psg-titech/FRMIDIConBoard1/README.md

# FRMIDIConBoard1
Functional Reactive MIDI Controller Board #1

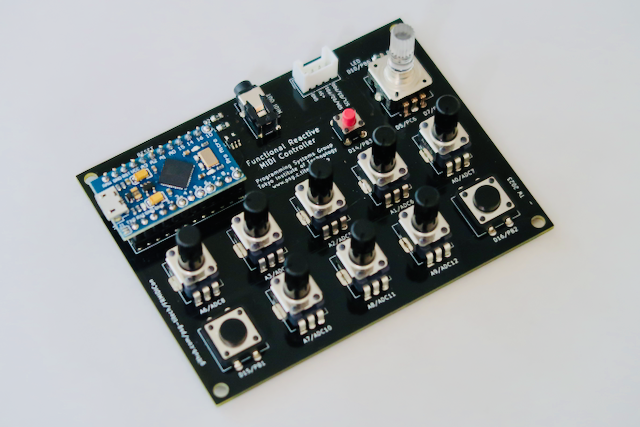
[picture p1: images/board.png]
Board Image
