psg-titech/FRMIDIConBoard1/docs/bom.xlsx

ID | Description | Model | Manufacturer | PCS | Manufacturer URL | Shop URL1 | Shop URL2
U1 | Single Buffer Gate | 74AHC1G125W5 | Diodes Incorporated | 1 |  | https://akizukidenshi.com/catalog/g/gI-17605/
C1 | Ceramic Capasitor 0.1u SMD 2012 | TMK212F104ZQ-T | Taiyo Yuden | 1 |  | https://akizukidenshi.com/catalog/g/gP-17818/
R1, R2 | Resistor 220ohm SMD 2012 | RK73B2ATTD221J | KOA | 2 | https://www.koaglobal.com/~/media/Files/KOA_Global/EN/product/commonpdf/rk73b | https://www.sengoku.co.jp/mod/sgk_cart/detail.php?code=EEHD-57BH
R3 | Resistor 470ohm SMD 2012 | RK73B2ATTD471J | KOA | 1 | https://www.koaglobal.com/~/media/Files/KOA_Global/EN/product/commonpdf/rk73b | https://www.sengoku.co.jp/mod/sgk_cart/detail.php?code=EEHD-57BS
SW1, SW2 | Tactical Switch 12mm TH | TVGP01-G73BB | Zhejiang Jianfu Electronics | 2 |  | https://akizukidenshi.com/catalog/g/gP-09826/ | https://www.amazon.co.jp/gp/product/B07J66NDTR
SW3 | Rotary Encoder with LED | EC12PLRVF-D-24K-24-24C-02/06-6 | Top-Up Industry Corporation | 1 |  | https://akizukidenshi.com/catalog/g/gP-05762/
SW4 | Tactical Switch 6mm TH | DTS-63-F-N-V-RED | Cosland Co,. Ltd. | 1 |  | https://akizukidenshi.com/catalog/g/gP-03646/
SW5 | Tactical Switch 6mm SMD | TVAF06-A020B-R | Zhejiang Jianfu Electronics | 1 |  | https://akizukidenshi.com/catalog/g/gP-14888/
RV1-8 | Rotary Potentiometer 10KB | RK09K1130A5R | Alps Alpine | 8 | https://tech.alpsalpine.com/j/products/detail/RK09K1130A5R/ | https://www.zaikostore.com/zaikostore/stockDetail?productName_forFind=RK09K1130A5R | https://www.amazon.co.jp/gp/product/B07TFTK41V
J1 | IC Socket 24P 600mil | 2227MC-24-06 | Neltron Industrial | 1 |  | https://akizukidenshi.com/catalog/g/gP-00032/
J2 | Grove Female Header 4pin/2mm TH | SKU110990030 | Seeed Studio | 1 | https://www.seeedstudio.com/Grove-Universal-4-pin-connector.html | https://www.switch-science.com/products/1122 | https://www.sengoku.co.jp/mod/sgk_cart/detail.php?code=EEHD-4KKK | https://www.marutsu.co.jp/pc/i/829425/
J3 | 3.5mm Phone Jack | ST-005-G | Switronic lndustrial Corp. | 1 |  | https://akizukidenshi.com/catalog/g/gC-02460/
 | Microcontroller Board | Pro Micro 5V/16MHz | Sparkfun | 1 | https://www.sparkfun.com/products/12640 | https://www.switch-science.com/products/1623
 | IC Connector 2.54mm 1x40 | 6604P-40G-121 | Neltron Industrial | 1 |  | https://akizukidenshi.com/catalog/g/gP-01382/
