psg-titech/FRMIDIConBoard1/docs/schematic.pdf

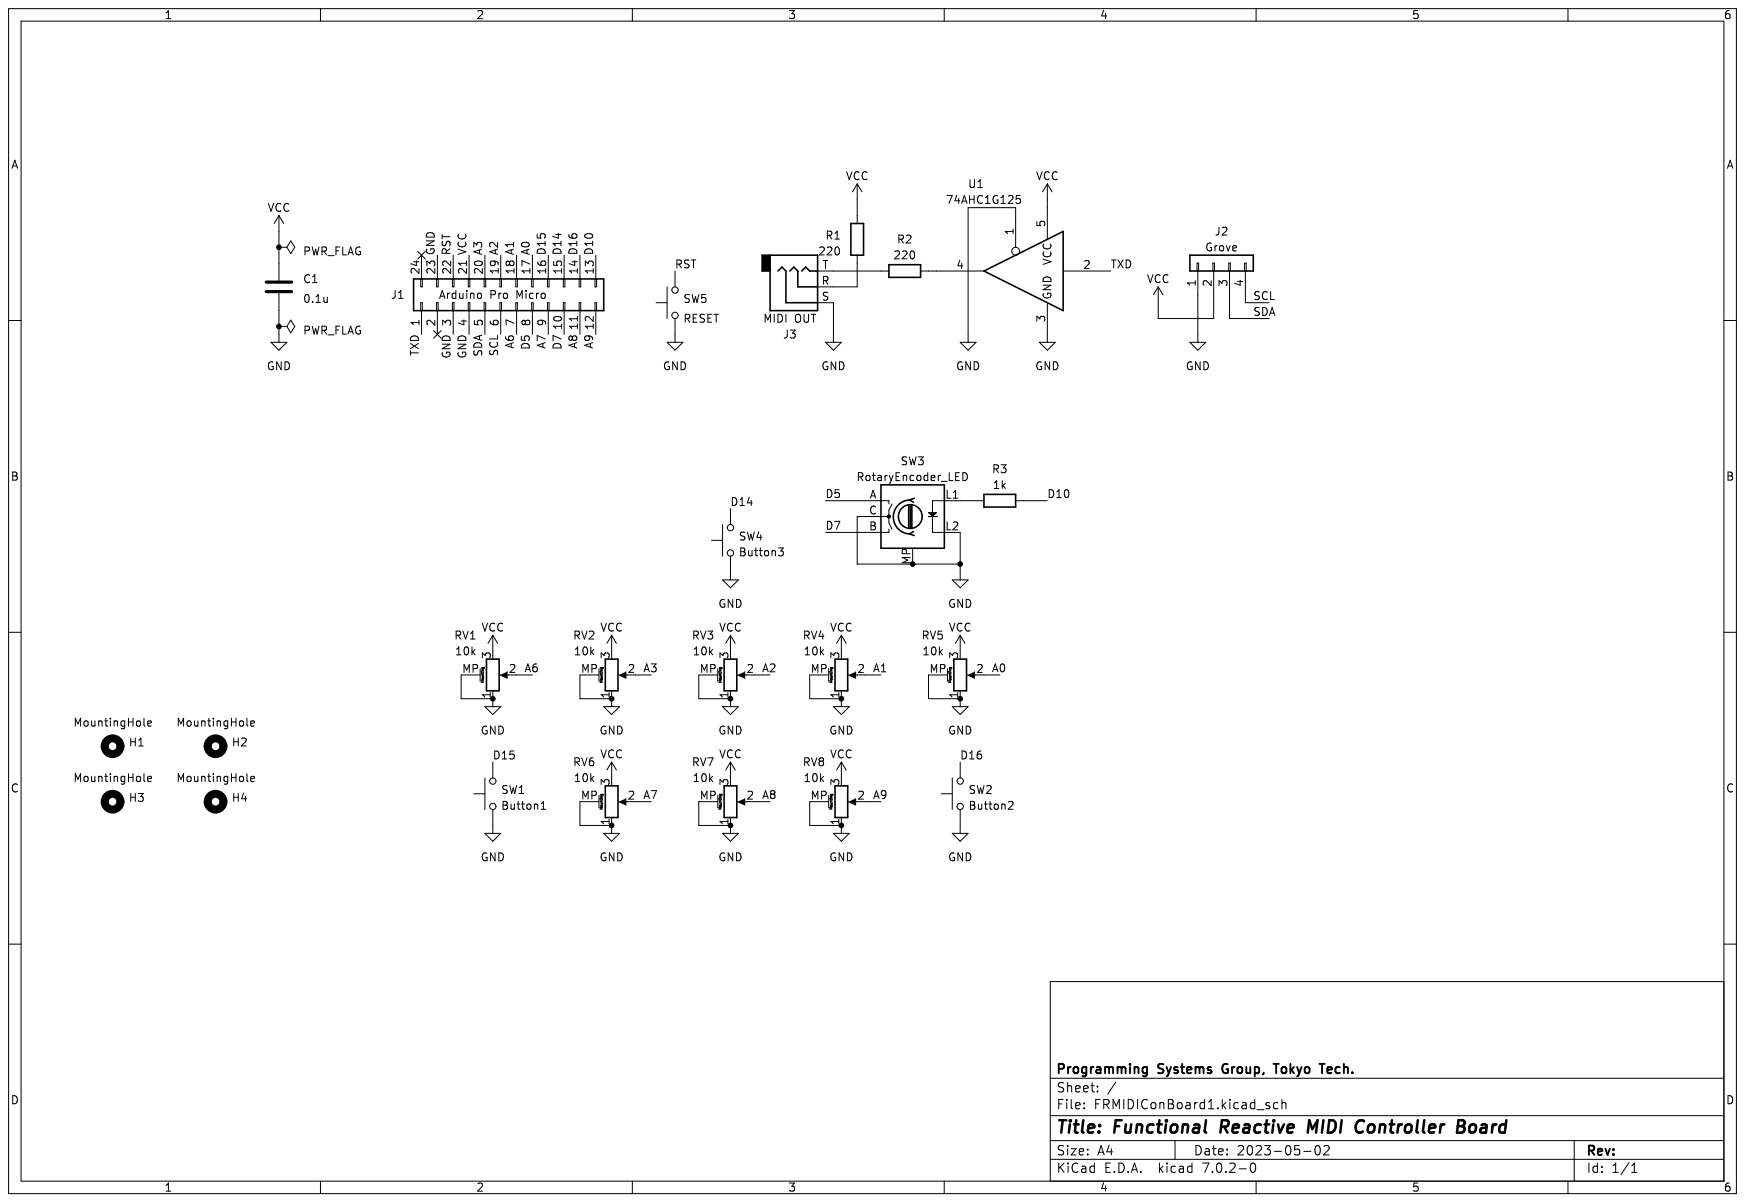
[picture p2: page 1]
