psg-titech/FRMIDIConBoard1/FRMIDIConBoard1.kicad_pcb

## KiCad design FRMIDIConBoard1.kicad_pcb (2023-05-13)

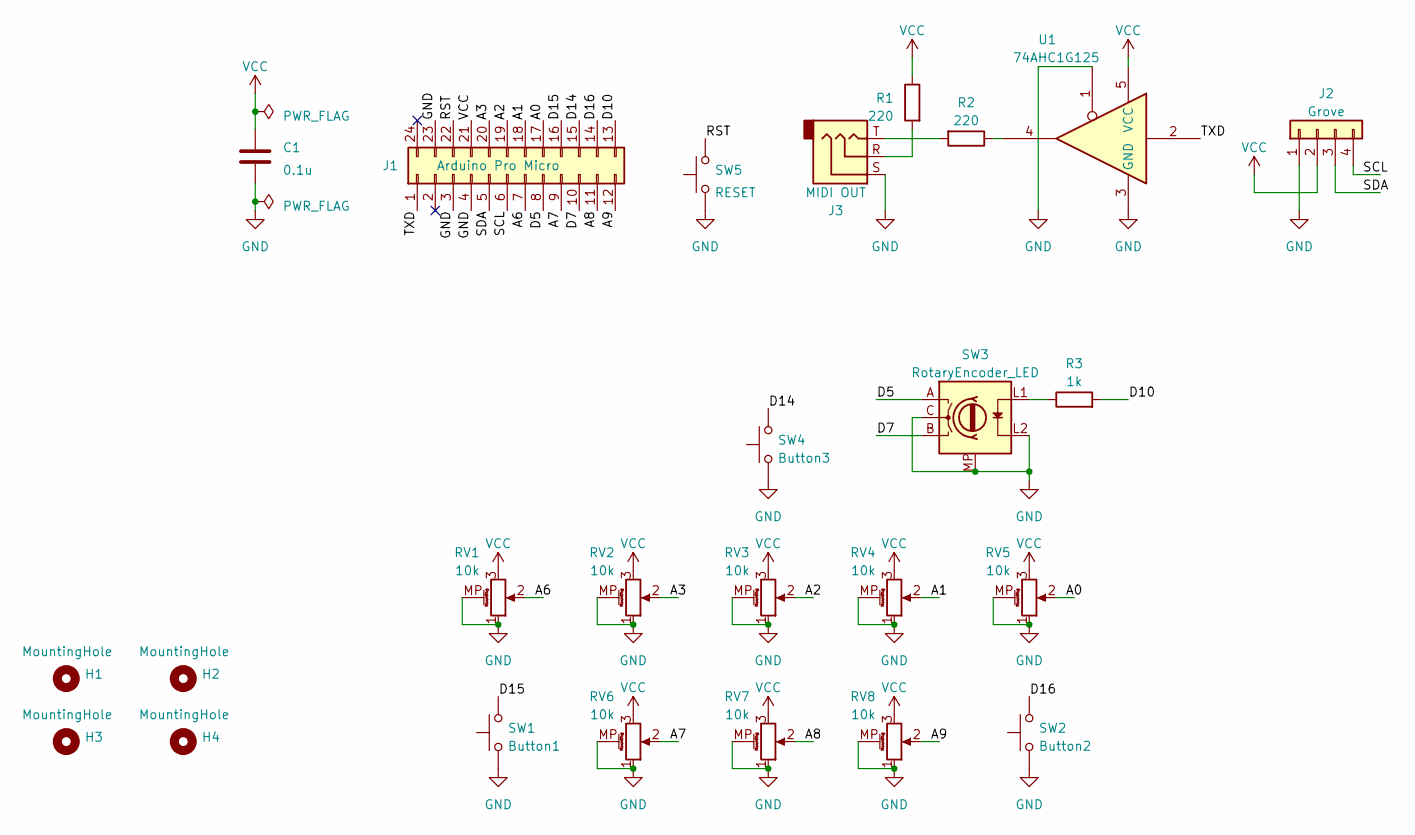
[picture p3: schematic FRMIDIConBoard1.kicad_sch, Functional Reactive MIDI Controller Board]

Parts:
C1: 0.1u; C_0805_2012Metric_Pad1.18x1.45mm_HandSolder
H1, H2, H3, H4: MountingHole; MountingHole_3.2mm_M3_ISO14580
J1: Arduino Pro Micro; DIP-24_W15.24mm_Socket_LongPads
J2: Grove; NS-Tech_Grove_1x04_P2mm_Vertical
J3: MIDI OUT; Jack_3.5mm_Switronic_ST-005-G_horizontal
R1, R2: 220; R_0805_2012Metric_Pad1.20x1.40mm_HandSolder
R3: 1k; R_0805_2012Metric_Pad1.20x1.40mm_HandSolder
RV1, RV2, RV3, RV4, RV5, RV6, RV7, RV8: 10k; Potentiometer_Alps_RK09K_Single_Vertical
SW1: Button1; SW_PUSH-12mm
SW2: Button2; SW_PUSH-12mm
SW3: RotaryEncoder_LED; RotaryEncoder_TopUp_EC12PL-LED_Vertical_H20mm_CircularMount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
SW4: Button3; SW_PUSH_6mm_H5mm
SW5: RESET; SW_Push_SPST_NO_Alps_SKRK
U1: 74AHC1G125; SOT-23-5_HandSoldering

Connections:
/A0: J1.17, RV5.2
/A1: J1.18, RV4.2
/A2: J1.19, RV3.2
/A3: J1.20, RV2.2
/A6: J1.7, RV1.2
/A7: J1.9, RV6.2
/A8: J1.11, RV7.2
/A9: J1.12, RV8.2
/D5: J1.8, SW3.A
/D7: J1.10, SW3.B
/D10: J1.13, R3.2
/D14: J1.15, SW4.2
/D15: J1.16, SW1.2
/D16: J1.14, SW2.2
/RST: J1.22, SW5.2
/SCL: J1.6, J2.4
/SDA: J1.5, J2.3
/TXD: J1.1, U1.2
GND: C1.2, J1.3, J1.4, J1.23, J2.1, J3.S, RV1.1, RV1.MP (MountPin), RV2.1, RV2.MP (MountPin), RV3.1, RV3.MP (MountPin), RV4.1, RV4.MP (MountPin), RV5.1, RV5.MP (MountPin), RV6.1, RV6.MP (MountPin), RV7.1, RV7.MP (MountPin), RV8.1, RV8.MP (MountPin), SW1.1, SW2.1, SW3.C, SW3.L2, SW3.MP, SW4.1, SW5.1, U1.1, U1.3 (GND)
unnamed: J3.R, R1.2
unnamed: J3.T, R2.2
unnamed: R2.1, U1.4
unnamed: R3.1, SW3.L1
VCC: C1.1, J1.21, J2.2, R1.1, RV1.3, RV2.3, RV3.3, RV4.3, RV5.3, RV6.3, RV7.3, RV8.3, U1.5 (VCC)

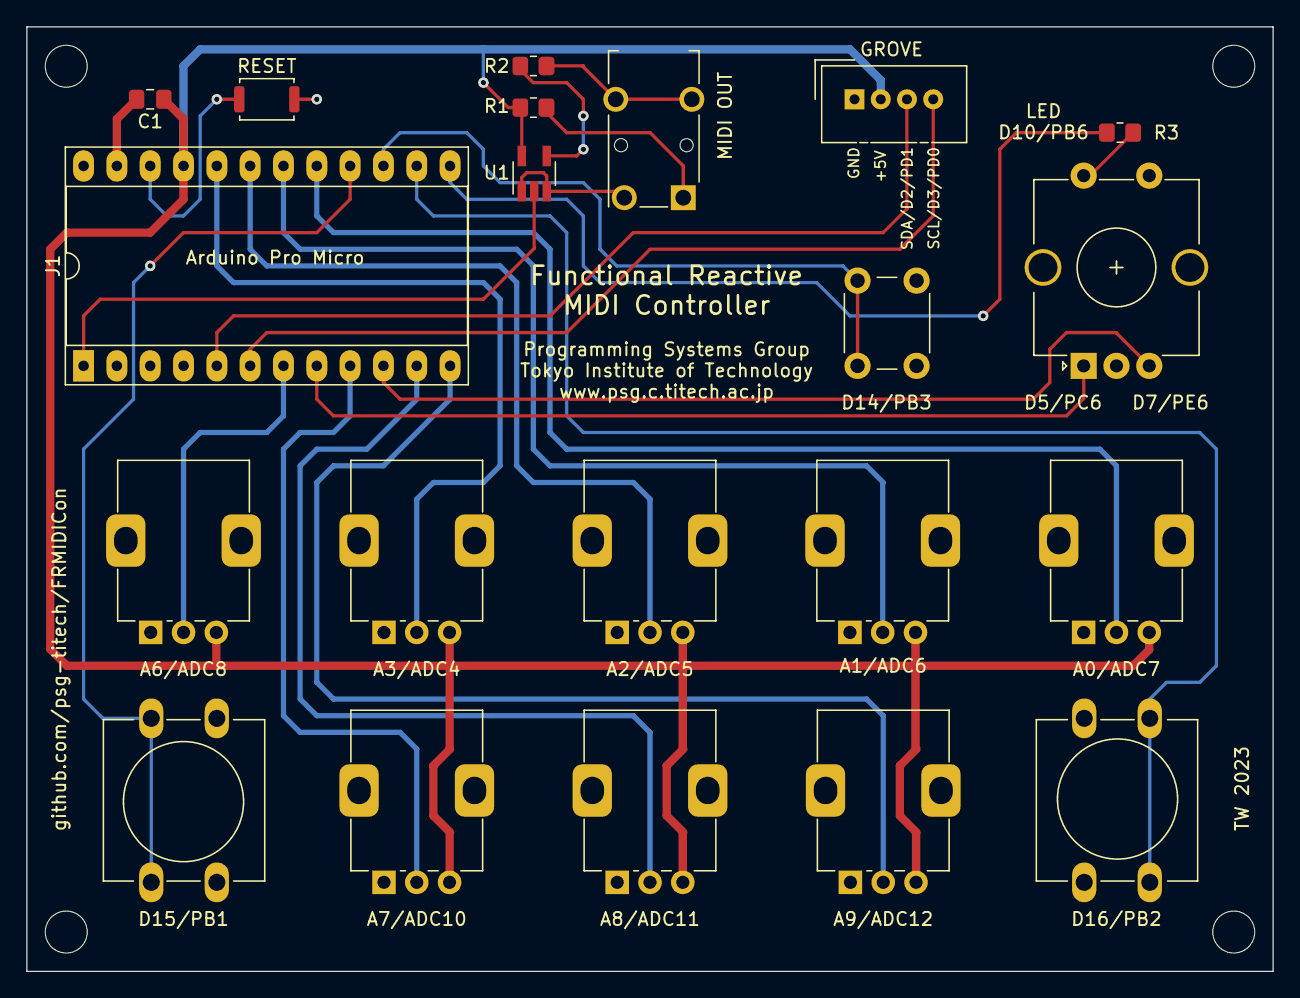
[picture p4: board FRMIDIConBoard1.kicad_pcb from above]

Board: 2 copper layers, 95.0 x 72.0 mm, 25 parts (0 on the bottom side), 24 nets.
