psg-titech/FRMIDIConBoard1/docs/assemble.pdf

## Functional Reactive MIDI Controller ボード組み立て方法

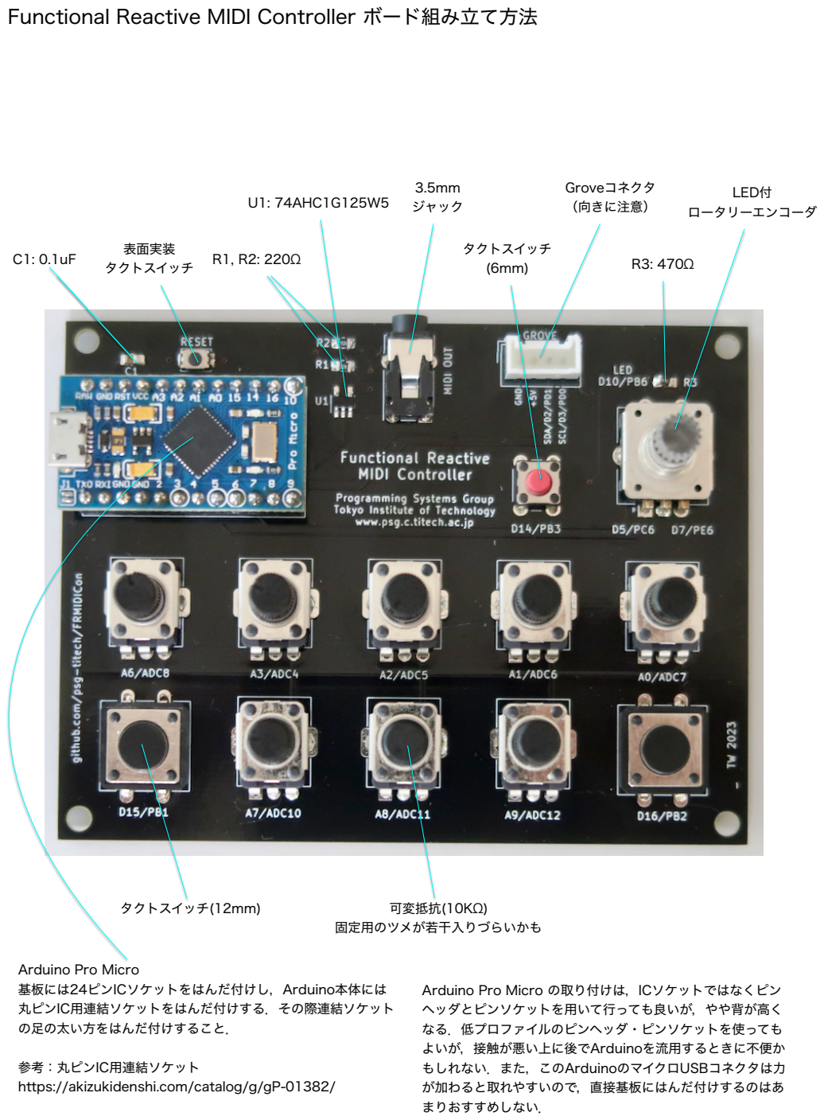
[picture p5: page 1]

C1: 0.1uF | R1, R2: 220Ω | R3: 470Ω
| U1: 74AHC1G125W5 | Groveコネクタ （向きに注意）

表面実装
タクトスイッチ

LED付
| | ロータリーエンコーダ
タクトスイッチ
(6mm)
タクトスイッチ(12mm) | 可変抵抗(10KΩ) 固定用のツメが若干入りづらいかも

3.5mm
ジャック

Arduino Pro Micro
基板には24ピンICソケットをはんだ付けし，Arduino本体には 丸ピンIC用連結ソケットをはんだ付けする．その際連結ソケット の足の太い方をはんだ付けすること．

参考：丸ピンIC用連結ソケット
https://akizukidenshi.com/catalog/g/gP-01382/

Arduino Pro Micro の取り付けは，ICソケットではなくピン ヘッダとピンソケットを用いて行っても良いが，やや背が高く なる．低プロファイルのピンヘッダ・ピンソケットを使っても よいが，接触が悪い上に後でArduinoを流用するときに不便か もしれない．また，このArduinoのマイクロUSBコネクタは力 が加わると取れやすいので，直接基板にはんだ付けするのはあ まりおすすめしない．
